chcbaram/stm32h5-w6300/hardware/stm32h5_w6300 v1.pdf

D

6 | 5 | 4 | 3 | 2 | 1

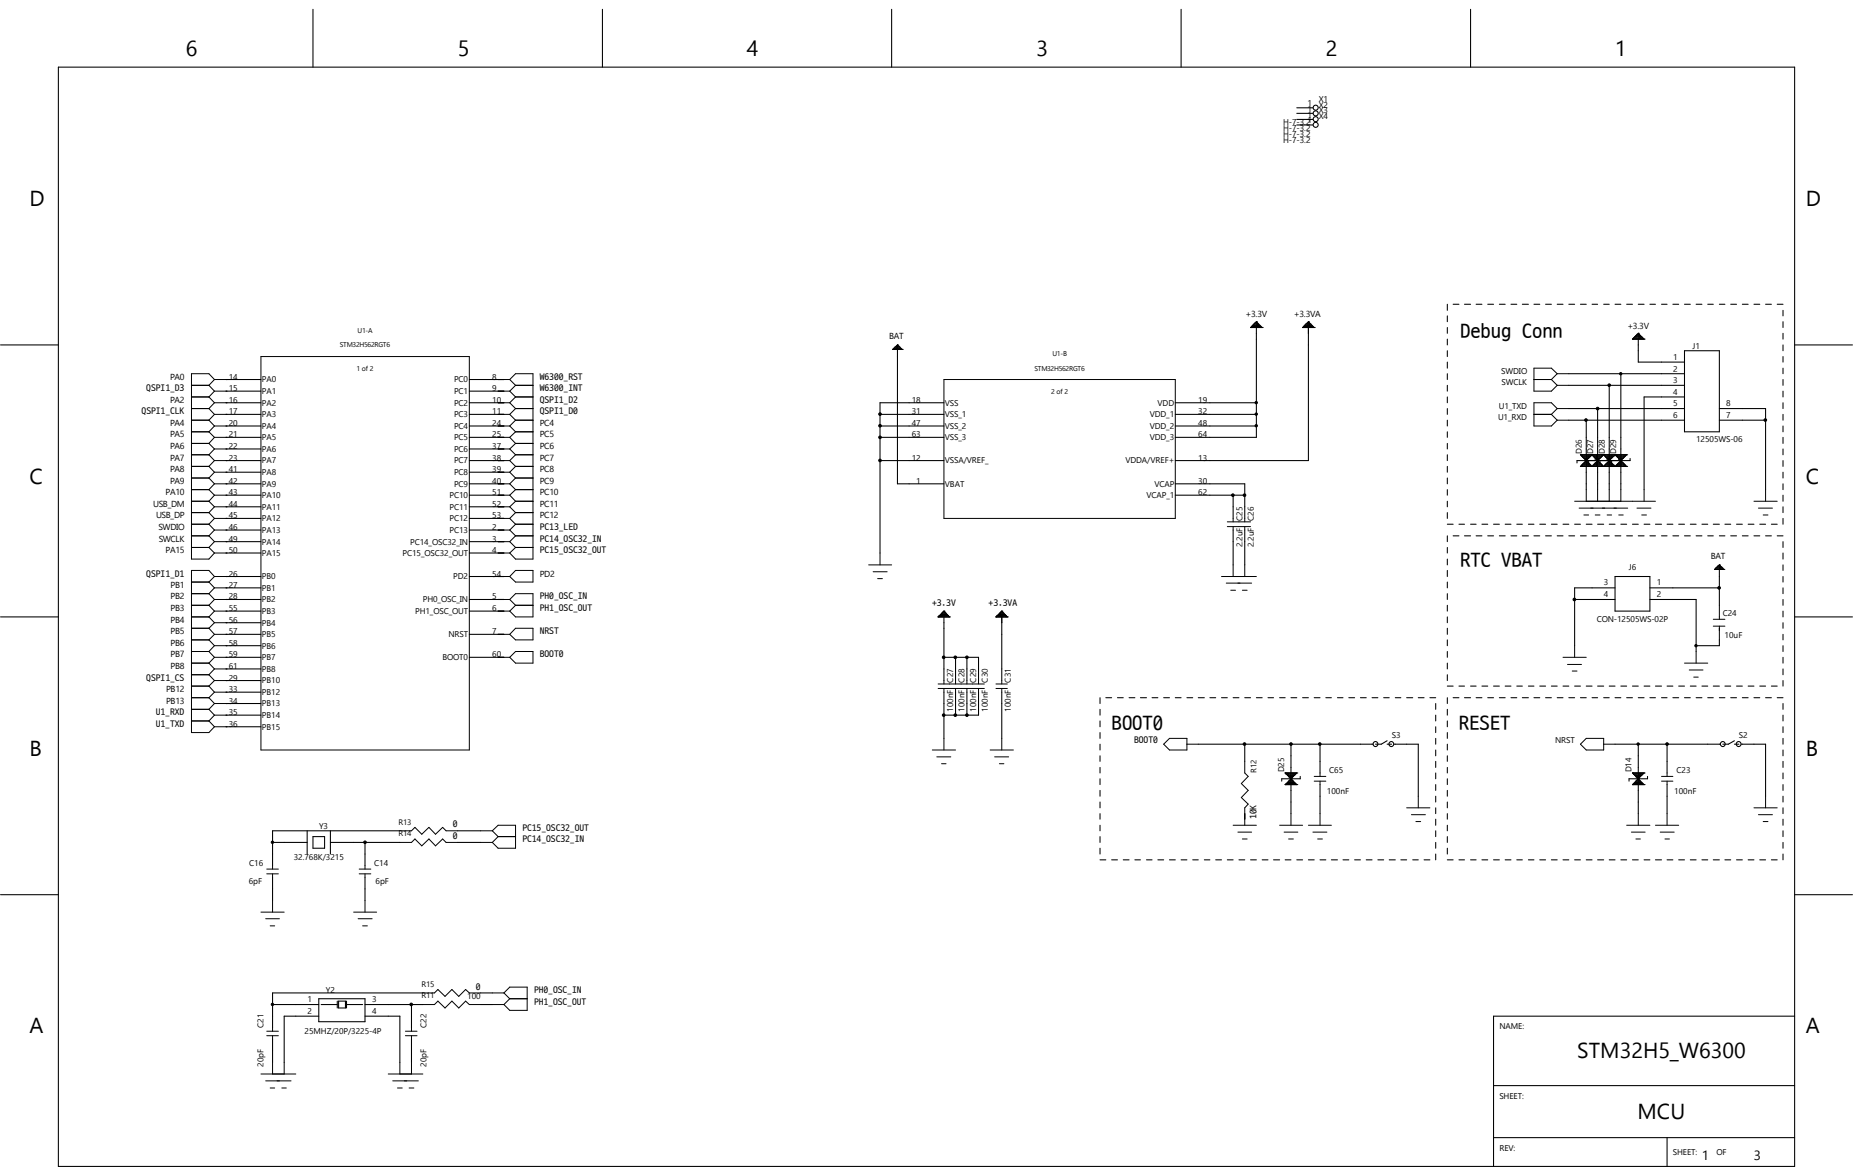
[picture p1: page 1]

12505WS-06 D²⁶ D²⁷ D²⁸ D²⁹

D

6 | 5 | 4 | 3 | 2 | 1

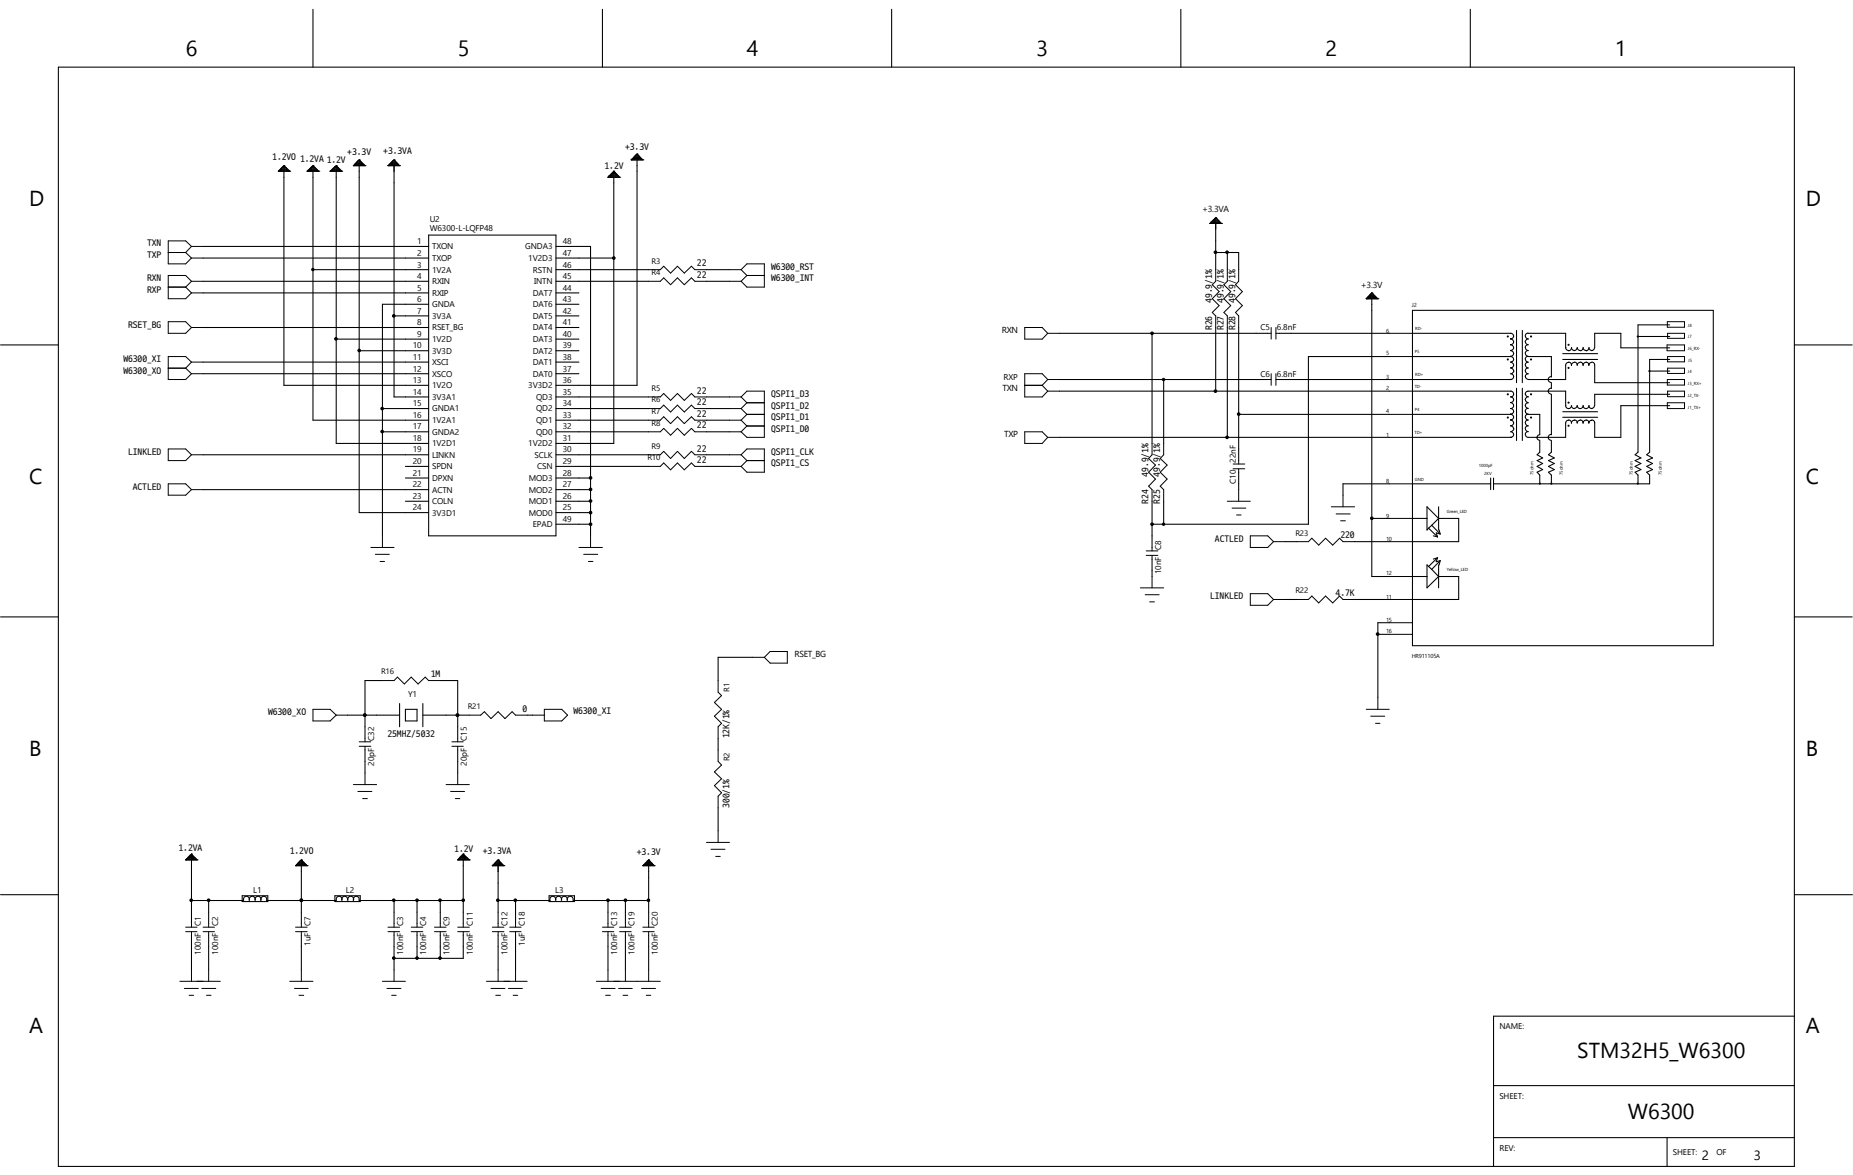
[picture p2: page 2]

2 | 47 1V2D3
3 | 46 RSTN 45 INTN 44 DAT7 43 DAT6 42 DAT5 41 DAT4 40 DAT3 39 DAT2 38 DAT1 37 DAT0 36 3V3D2

D

6 | 5 | 4 | 3 | 2 | 1

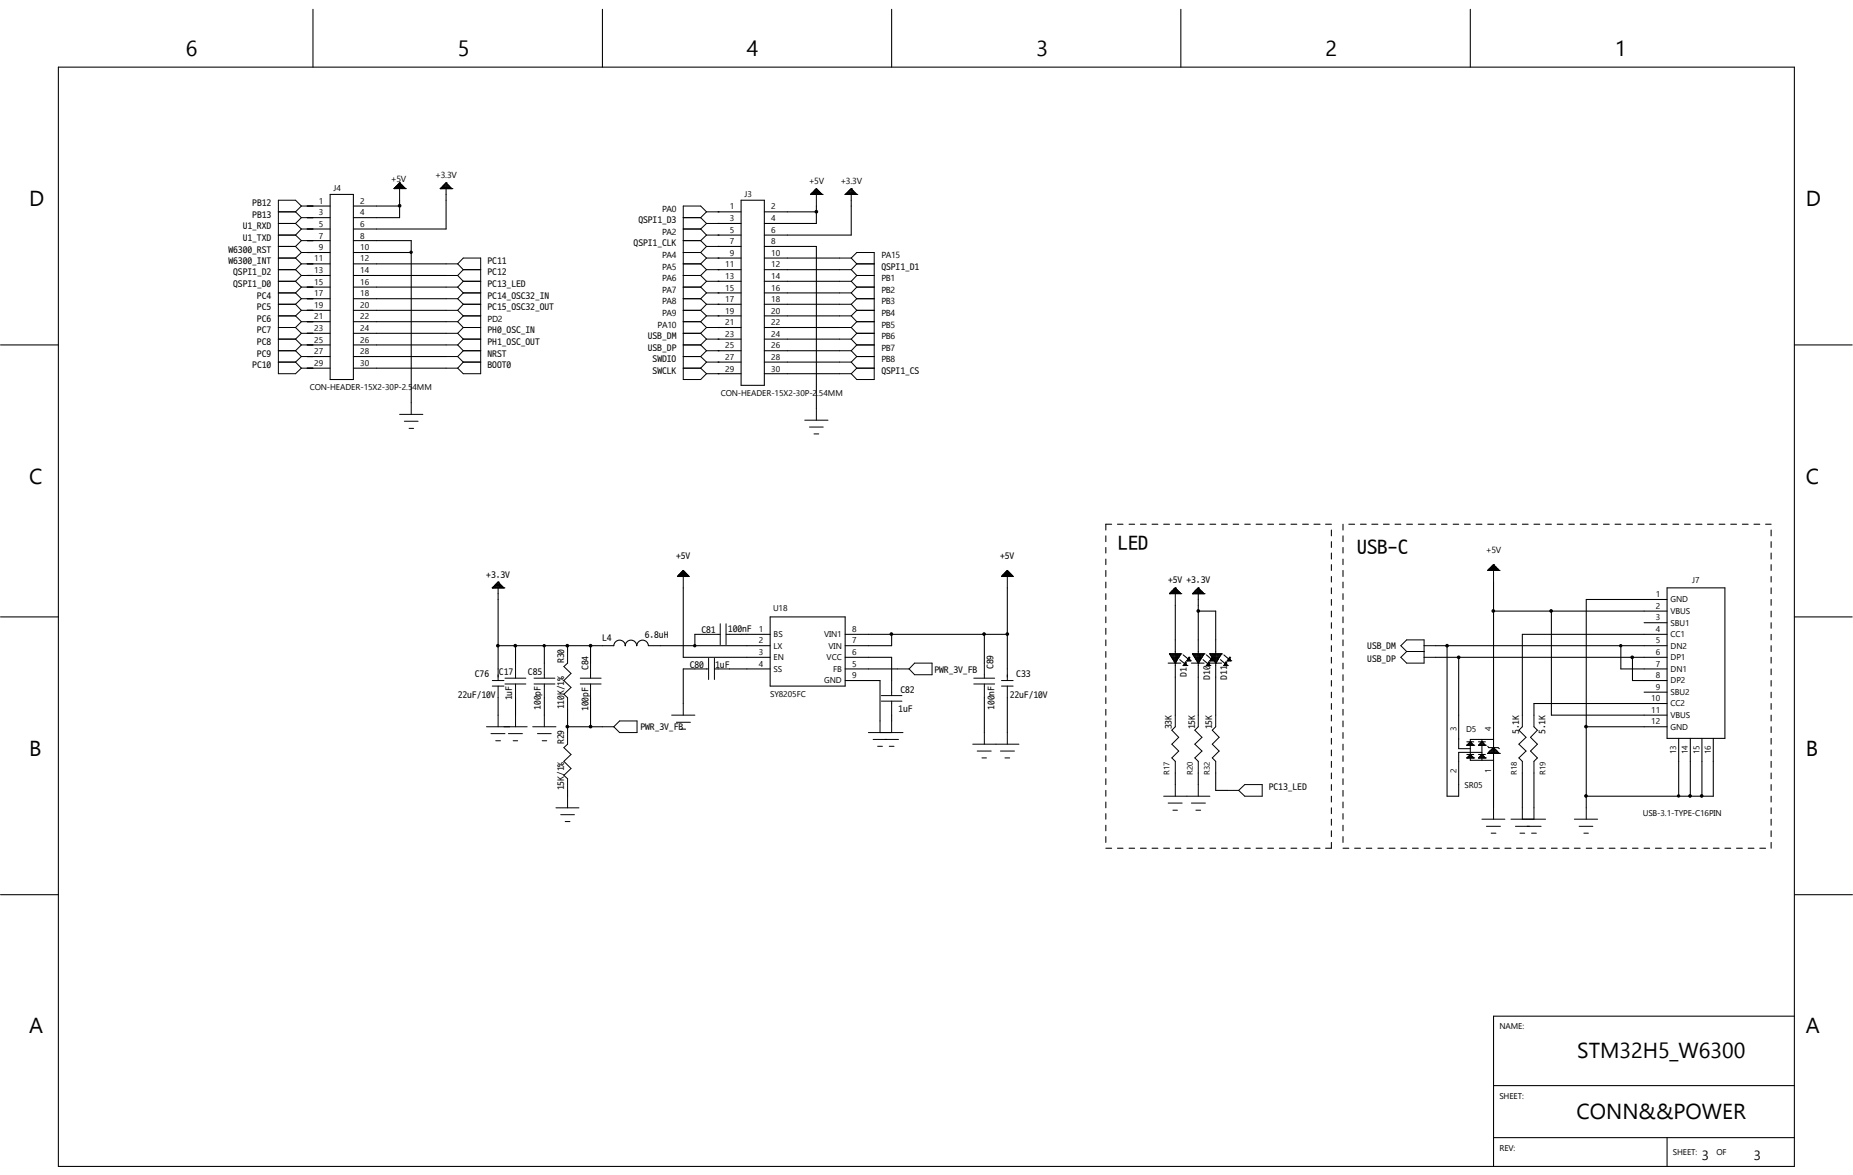
[picture p3: page 3]
