chcbaram/stm32h5-w6300/firmware/stm32h5-cube/stm32h5-w6300.ioc

Mcu.UserName=STM32H563RITx
PA1.Signal=OCTOSPI1_IO3
PA11.Signal=USB_DM
PA12.Signal=USB_DP
PA13(JTMS/SWDIO).Signal=DEBUG_JTMS-SWDIO
PA14(JTCK/SWCLK).Signal=DEBUG_JTCK-SWCLK
PA3.Signal=OCTOSPI1_CLK
PB0.Signal=OCTOSPI1_IO1
PB10.Signal=OCTOSPI1_NCS
PB14.Signal=USART1_TX
PB15.Signal=USART1_RX
PC13.GPIO_Label=LED
PC13.Signal=GPIO_Output
PC14-OSC32_IN(OSC32_IN).Signal=RCC_OSC32_IN
PC15-OSC32_OUT(OSC32_OUT).Signal=RCC_OSC32_OUT
PC2.Signal=OCTOSPI1_IO2
PC3.Signal=OCTOSPI1_IO0
PH0-OSC_IN(PH0).Signal=RCC_OSC_IN
PH1-OSC_OUT(PH1).Signal=RCC_OSC_OUT
