chcbaram/stm32h5-w6300/firmware/stm32h5-fw/src/hw/driver/uart.c

#include "uart.h"
#include "qbuffer.h"
#include "cli.h"
#if HW_USE_CDC == 1
#include "cdc.h"
#endif

#ifdef _USE_HW_UART


#define UART_RX_BUF_LENGTH        1024



typedef struct
{
  bool is_open;
  uint32_t baud;

  uint8_t  rx_buf[UART_RX_BUF_LENGTH];
  qbuffer_t qbuffer;
  UART_HandleTypeDef *p_huart;
  DMA_HandleTypeDef  *p_hdma_rx;

  uint32_t rx_cnt;
  uint32_t tx_cnt;
} uart_tbl_t;

typedef struct
{
  const char         *p_msg;
  USART_TypeDef      *p_uart;
  UART_HandleTypeDef *p_huart;
  bool                is_rs485;
  uart_driver_t      *p_driver;
} uart_hw_t;



#if CLI_USE(HW_UART)
static void cliUart(cli_args_t *args);
#endif


static bool is_init = false;

// .non_cache 섹션은 링커스크립트에 정의되어 있지 않아 orphan 으로 배치된다.
// 그 결과 startup 의 .data 복사(_sdata.._edata)와 .bss 클리어(_sbss.._ebss)
// 어느 쪽에도 포함되지 않아 부팅 시 쓰레기값이 남고, 플래시도 낭비된다.
// non-cacheable 배치 자체가 불필요하므로 속성을 뗀다.
static uart_tbl_t uart_tbl[UART_MAX_CH];

static UART_HandleTypeDef huart1;
static DMA_NodeTypeDef Node_GPDMA1_Channel0;
static DMA_QListTypeDef List_GPDMA1_Channel0;
static DMA_HandleTypeDef handle_GPDMA1_Channel0;

//   UART3/4 는 물리 포트가 아니라 uartSetDriver() 로 붙는 가상 채널이다.
//   NET  : cli_net.c   (텔넷)
//   CMD  : drv_cli.c   (cmd 패킷 위의 CLI. HID/CDC 어느 쪽이든 여기로 온다)
//   항목 수가 UART_MAX_CH 와 어긋나면 나머지가 0 으로 채워져 이름이 NULL 이 된다.
static uart_hw_t uart_hw_tbl[UART_MAX_CH] = 
  {
    {"USART1 SWD   ", USART1, &huart1, false, NULL},
    {"USB CDC      ", NULL,   NULL   , false, NULL},
    {"NET TELNET   ", NULL,   NULL   , false, NULL},
    {"CMD CLI      ", NULL,   NULL   , false, NULL},
  };





bool uartInit(void)
{
  for (int i=0; i<UART_MAX_CH; i++)
  {
    uart_tbl[i].is_open = false;
    uart_tbl[i].baud = 57600;
    uart_tbl[i].rx_cnt = 0;
    uart_tbl[i].tx_cnt = 0;    
  }

  is_init = true;

#if CLI_USE(HW_UART)
  cliAdd("uart", cliUart);
#endif
  return true;
}

bool uartSetDriver(uint8_t ch, uart_driver_t *p_driver)
{
  if (ch >= UART_MAX_CH)
    return false;

  uart_hw_tbl[ch].p_driver = p_driver;
  return true;
}

bool uartDeInit(void)
{
  return true;
}

bool uartIsInit(void)
{
  return is_init;
}

bool uartOpen(uint8_t ch, uint32_t baud)
{
  bool ret = false;
  HAL_StatusTypeDef ret_hal;


  if (ch >= UART_MAX_CH) return false;

  if (uart_tbl[ch].is_open == true && uart_tbl[ch].baud == baud)
  {
    return true;
  }

  if (uart_hw_tbl[ch].p_driver != NULL)
  {
    ret                  = uart_hw_tbl[ch].p_driver->open(baud);
    uart_tbl[ch].is_open = ret;
    uart_tbl[ch].baud    = baud;
    return ret;
  }  

  switch(ch)
  {
    case _DEF_UART1:
      uart_tbl[ch].baud      = baud;

      uart_tbl[ch].p_huart   = uart_hw_tbl[ch].p_huart;
      uart_tbl[ch].p_huart->Instance = uart_hw_tbl[ch].p_uart;    

      uart_tbl[ch].p_huart->Init.BaudRate       = baud;
      uart_tbl[ch].p_huart->Init.WordLength     = UART_WORDLENGTH_8B;
      uart_tbl[ch].p_huart->Init.StopBits       = UART_STOPBITS_1;
      uart_tbl[ch].p_huart->Init.Parity         = UART_PARITY_NONE;
      uart_tbl[ch].p_huart->Init.Mode           = UART_MODE_TX_RX;
      uart_tbl[ch].p_huart->Init.HwFlowCtl      = UART_HWCONTROL_NONE;
      uart_tbl[ch].p_huart->Init.OverSampling   = UART_OVERSAMPLING_16;
      uart_tbl[ch].p_huart->Init.OneBitSampling = UART_ONE_BIT_SAMPLE_DISABLE;
      uart_tbl[ch].p_huart->Init.ClockPrescaler = UART_PRESCALER_DIV1;
      uart_tbl[ch].p_huart->AdvancedInit.AdvFeatureInit = UART_ADVFEATURE_SWAP_INIT;
      uart_tbl[ch].p_huart->AdvancedInit.Swap           = UART_ADVFEATURE_SWAP_ENABLE;


      qbufferCreate(&uart_tbl[ch].qbuffer, &uart_tbl[ch].rx_buf[0], UART_RX_BUF_LENGTH);


      __HAL_RCC_GPDMA1_CLK_ENABLE();

      HAL_UART_DeInit(uart_tbl[ch].p_huart);

      if (uart_hw_tbl[ch].is_rs485 == true)
      {
        ret_hal = HAL_RS485Ex_Init(uart_tbl[ch].p_huart, UART_DE_POLARITY_HIGH, 0, 0);
      }
      else
      {
        ret_hal = HAL_UART_Init(uart_tbl[ch].p_huart);
      }

      if (ret_hal == HAL_OK)
      {
        ret = true;
        uart_tbl[ch].is_open = true;

        if(HAL_UART_Receive_DMA(uart_tbl[ch].p_huart, (uint8_t *)&uart_tbl[ch].rx_buf[0], UART_RX_BUF_LENGTH) != HAL_OK)
        {
          ret = false;
        }

        uart_tbl[ch].qbuffer.in  = uart_tbl[ch].qbuffer.len - uart_tbl[ch].p_huart->hdmarx->Instance->CBR1;
        uart_tbl[ch].qbuffer.out = uart_tbl[ch].qbuffer.in;
      }
      break;

    case _DEF_UART2:
      uart_tbl[ch].baud    = baud;
      uart_tbl[ch].is_open = true;
      ret = true;
      break;      
  }

  return ret;
}

bool uartClose(uint8_t ch)
{
  if (ch >= UART_MAX_CH) return false;

  uart_tbl[ch].is_open = false;

  if (uart_hw_tbl[ch].p_driver != NULL)
  {
    uart_hw_tbl[ch].p_driver->close();
  }

  return true;
}

uint32_t uartAvailable(uint8_t ch)
{
  uint32_t ret = 0;


  if (uart_hw_tbl[ch].p_driver != NULL)
  {
    ret = uart_hw_tbl[ch].p_driver->available();
    return ret;
  }

  switch(ch)
  {
    case _DEF_UART1:
      uart_tbl[ch].qbuffer.in = (uart_tbl[ch].qbuffer.len - uart_tbl[ch].p_huart->hdmarx->Instance->CBR1);
      ret = qbufferAvailable(&uart_tbl[ch].qbuffer);      
      break;

    case _DEF_UART2:
      #if HW_USE_CDC == 1
      ret = cdcAvailable();
      #endif
      break;      
  }

  return ret;
}

bool uartFlush(uint8_t ch)
{
  uint32_t pre_time;


  pre_time = millis();
  while(uartAvailable(ch))
  {
    if (millis()-pre_time >= 10)
    {
      break;
    }
    uartRead(ch);
  }

  return true;
}

uint8_t uartRead(uint8_t ch)
{
  uint8_t ret = 0;


  if (uart_hw_tbl[ch].p_driver != NULL)
  {
    ret = uart_hw_tbl[ch].p_driver->read();
    return ret;
  }

  switch(ch)
  {
    case _DEF_UART1:
      qbufferRead(&uart_tbl[ch].qbuffer, &ret, 1);
      break;

    case _DEF_UART2:
      #if HW_USE_CDC == 1
      ret = cdcRead();
      #endif
      break;      
  }
  uart_tbl[ch].rx_cnt++;

  return ret;
}

uint32_t uartWrite(uint8_t ch, uint8_t *p_data, uint32_t length)
{
  uint32_t ret = 0;


  if (uart_hw_tbl[ch].p_driver != NULL)
  {
    ret = uart_hw_tbl[ch].p_driver->write(p_data, length);
    return ret;
  }

  switch(ch)
  {
    case _DEF_UART1:
      if (HAL_UART_Transmit(uart_tbl[ch].p_huart, p_data, length, 100) == HAL_OK)
      {
        ret = length;
      }
      break;

    case _DEF_UART2:
      #if HW_USE_CDC == 1
      ret = cdcWrite(p_data, length);
      #endif
      break;      
  }
  uart_tbl[ch].tx_cnt += ret;

  return ret;
}

uint32_t uartPrintf(uint8_t ch, const char *fmt, ...)
{
  char buf[256];
  va_list args;
  int len;
  uint32_t ret;

  va_start(args, fmt);
  len = vsnprintf(buf, 256, fmt, args);

  ret = uartWrite(ch, (uint8_t *)buf, len);

  va_end(args);


  return ret;
}

uint32_t uartGetBaud(uint8_t ch)
{
  uint32_t ret = 0;


  if (ch >= UART_MAX_CH) return 0;

  #if HW_USE_CDC == 1
  if (ch == HW_UART_CH_USB)
    ret = cdcGetBaud();
  else
    ret = uart_tbl[ch].baud;
  #else
  ret = uart_tbl[ch].baud;
  #endif
  
  return ret;
}

uint32_t uartGetRxCnt(uint8_t ch)
{
  if (ch >= UART_MAX_CH) return 0;

  return uart_tbl[ch].rx_cnt;
}

uint32_t uartGetTxCnt(uint8_t ch)
{
  if (ch >= UART_MAX_CH) return 0;

  return uart_tbl[ch].tx_cnt;
}

void HAL_UART_MspInit(UART_HandleTypeDef* uartHandle)
{
  GPIO_InitTypeDef GPIO_InitStruct = {0};
  DMA_NodeConfTypeDef NodeConfig= {0};
  RCC_PeriphCLKInitTypeDef PeriphClkInitStruct = {0};

  if(uartHandle->Instance==USART1)
  {
  /** Initializes the peripherals clock
  */
    PeriphClkInitStruct.PeriphClockSelection = RCC_PERIPHCLK_USART1;
    PeriphClkInitStruct.Usart1ClockSelection = RCC_USART1CLKSOURCE_PCLK2;
    if (HAL_RCCEx_PeriphCLKConfig(&PeriphClkInitStruct) != HAL_OK)
    {
      Error_Handler();
    }

    /* USART1 clock enable */
    __HAL_RCC_USART1_CLK_ENABLE();

    __HAL_RCC_GPIOB_CLK_ENABLE();
    /**USART1 GPIO Configuration
    PB14     ------> USART1_TX
    PB15     ------> USART1_RX
    */
    GPIO_InitStruct.Pin = GPIO_PIN_14|GPIO_PIN_15;
    GPIO_InitStruct.Mode = GPIO_MODE_AF_PP;
    GPIO_InitStruct.Pull = GPIO_NOPULL;
    GPIO_InitStruct.Speed = GPIO_SPEED_FREQ_LOW;
    GPIO_InitStruct.Alternate = GPIO_AF4_USART1;
    HAL_GPIO_Init(GPIOB, &GPIO_InitStruct);


    /* USART1 DMA Init */
    /* GPDMA1_REQUEST_USART1_RX Init */
    NodeConfig.NodeType = DMA_GPDMA_LINEAR_NODE;
    NodeConfig.Init.Request = GPDMA1_REQUEST_USART1_RX;
    NodeConfig.Init.BlkHWRequest = DMA_BREQ_SINGLE_BURST;
    NodeConfig.Init.Direction = DMA_PERIPH_TO_MEMORY;
    NodeConfig.Init.SrcInc = DMA_SINC_FIXED;
    NodeConfig.Init.DestInc = DMA_DINC_INCREMENTED;
    NodeConfig.Init.SrcDataWidth = DMA_SRC_DATAWIDTH_BYTE;
    NodeConfig.Init.DestDataWidth = DMA_DEST_DATAWIDTH_BYTE;
    NodeConfig.Init.SrcBurstLength = 1;
    NodeConfig.Init.DestBurstLength = 1;
    NodeConfig.Init.TransferAllocatedPort = DMA_SRC_ALLOCATED_PORT0|DMA_DEST_ALLOCATED_PORT0;
    NodeConfig.Init.TransferEventMode = DMA_TCEM_BLOCK_TRANSFER;
    NodeConfig.Init.Mode = DMA_NORMAL;
    NodeConfig.TriggerConfig.TriggerPolarity = DMA_TRIG_POLARITY_MASKED;
    NodeConfig.DataHandlingConfig.DataExchange = DMA_EXCHANGE_NONE;
    NodeConfig.DataHandlingConfig.DataAlignment = DMA_DATA_RIGHTALIGN_ZEROPADDED;
    if (HAL_DMAEx_List_BuildNode(&NodeConfig, &Node_GPDMA1_Channel0) != HAL_OK)
    {
      Error_Handler();
    }

    if (HAL_DMAEx_List_InsertNode(&List_GPDMA1_Channel0, NULL, &Node_GPDMA1_Channel0) != HAL_OK)
    {
      Error_Handler();
    }

    if (HAL_DMAEx_List_SetCircularMode(&List_GPDMA1_Channel0) != HAL_OK)
    {
      Error_Handler();
    }

    handle_GPDMA1_Channel0.Instance = GPDMA1_Channel0;
    handle_GPDMA1_Channel0.InitLinkedList.Priority = DMA_LOW_PRIORITY_LOW_WEIGHT;
    handle_GPDMA1_Channel0.InitLinkedList.LinkStepMode = DMA_LSM_FULL_EXECUTION;
    handle_GPDMA1_Channel0.InitLinkedList.LinkAllocatedPort = DMA_LINK_ALLOCATED_PORT0;
    handle_GPDMA1_Channel0.InitLinkedList.TransferEventMode = DMA_TCEM_BLOCK_TRANSFER;
    handle_GPDMA1_Channel0.InitLinkedList.LinkedListMode = DMA_LINKEDLIST_CIRCULAR;
    if (HAL_DMAEx_List_Init(&handle_GPDMA1_Channel0) != HAL_OK)
    {
      Error_Handler();
    }

    if (HAL_DMAEx_List_LinkQ(&handle_GPDMA1_Channel0, &List_GPDMA1_Channel0) != HAL_OK)
    {
      Error_Handler();
    }

    __HAL_LINKDMA(uartHandle, hdmarx, handle_GPDMA1_Channel0);

    if (HAL_DMA_ConfigChannelAttributes(&handle_GPDMA1_Channel0, DMA_CHANNEL_NPRIV) != HAL_OK)
    {
      Error_Handler();
    }
  }
}

void HAL_UART_MspDeInit(UART_HandleTypeDef* uartHandle)
{
  if(uartHandle->Instance==USART1)
  {
    /* Peripheral clock disable */
    __HAL_RCC_USART1_CLK_DISABLE();

    /**USART1 GPIO Configuration
    PB14     ------> USART1_TX
    PB15     ------> USART1_RX
    */
    HAL_GPIO_DeInit(GPIOB, GPIO_PIN_14|GPIO_PIN_15);

    /* USART1 DMA DeInit */
    HAL_DMA_DeInit(uartHandle->hdmarx);
  }
}

#if CLI_USE(HW_UART)
void cliUart(cli_args_t *args)
{
  bool ret = false;


  if (args->argc == 1 && args->isStr(0, "info"))
  {
    for (int i=0; i<UART_MAX_CH; i++)
    {
      cliPrintf("_DEF_UART%d : %s, %d bps\n", i+1, uart_hw_tbl[i].p_msg, uartGetBaud(i));
    }
    ret = true;
  }

  if (args->argc == 2 && args->isStr(0, "test"))
  {
    uint8_t uart_ch;

    uart_ch = constrain(args->getData(1), 1, UART_MAX_CH) - 1;

    if (uart_ch != cliGetPort())
    {
      uint8_t rx_data;

      while(1)
      {
        if (uartAvailable(uart_ch) > 0)
        {
          rx_data = uartRead(uart_ch);
          cliPrintf("<- _DEF_UART%d RX : 0x%X\n", uart_ch + 1, rx_data);
        }

        if (cliAvailable() > 0)
        {
          rx_data = cliRead();
          if (rx_data == 'q')
          {
            break;
          }
          else
          {
            uartWrite(uart_ch, &rx_data, 1);
            cliPrintf("-> _DEF_UART%d TX : 0x%X\n", uart_ch + 1, rx_data);            
          }
        }
      }
    }
    else
    {
      cliPrintf("This is cliPort\n");
    }
    ret = true;
  }

  if (ret == false)
  {
    cliPrintf("uart info\n");
    cliPrintf("uart test ch[1~%d]\n", HW_UART_MAX_CH);
  }
}
#endif


#endif
