chcbaram/stm32h5-w6300/firmware/stm32h5-fw/src/hw/hw.h

#ifndef HW_H_
#define HW_H_

#ifdef __cplusplus
extern "C" {
#endif

#include "hw_def.h"


#include "led.h"
#include "uart.h"
#include "cli.h"
#include "log.h"
#include "fault.h"
#include "swtimer.h"
#include "reset.h"
#include "rtc.h"
#include "qbuffer.h"
#include "util_core.h"
#include "usb.h"
#include "cdc.h"
#include "hid.h"
#include "gpio.h"
#include "flash.h"
#include "wiz_spi.h"
#ifdef _USE_HW_WIZNET
#include "wiznet/wiznet.h"
#endif
#include "event.h"
#include "osal/thread.h"


bool hwInit(void);


#ifdef __cplusplus
}
#endif

#endif
