chcbaram/stm32h5-w6300/firmware/stm32h5-fw/src/hw/driver/rtc.c

#include "rtc.h"
#include "util_core.h"



#ifdef _USE_HW_RTC
#include "cli.h"
#include <time.h>


#ifdef _USE_HW_CLI
static void cliRtc(cli_args_t *args);
#endif

static RTC_HandleTypeDef hrtc;
static bool is_init = false;





bool rtcInit(void)
{
  bool ret = true;
  RTC_PrivilegeStateTypeDef privilegeState = {0};

  hrtc.Instance = RTC;
  hrtc.Init.HourFormat = RTC_HOURFORMAT_24;
  hrtc.Init.AsynchPrediv = 127;
  hrtc.Init.SynchPrediv = 255;
  hrtc.Init.OutPut = RTC_OUTPUT_DISABLE;
  hrtc.Init.OutPutRemap = RTC_OUTPUT_REMAP_NONE;  
  hrtc.Init.OutPutPolarity = RTC_OUTPUT_POLARITY_HIGH;
  hrtc.Init.OutPutType = RTC_OUTPUT_TYPE_OPENDRAIN;
  hrtc.Init.OutPutRemap = RTC_OUTPUT_REMAP_NONE;
  if (HAL_RTC_Init(&hrtc) != HAL_OK)
  {
    ret = false;
  }

  privilegeState.rtcPrivilegeFull = RTC_PRIVILEGE_FULL_NO;
  privilegeState.backupRegisterPrivZone = RTC_PRIVILEGE_BKUP_ZONE_NONE;
  privilegeState.backupRegisterStartZone2 = RTC_BKP_DR0;
  privilegeState.backupRegisterStartZone3 = RTC_BKP_DR0;
  if (HAL_RTCEx_PrivilegeModeSet(&hrtc, &privilegeState) != HAL_OK)
  {
    Error_Handler();
  }

  logPrintf("[%s] rtcInit()\n", ret ? "OK":"E_");
  is_init = ret;

#ifdef _USE_HW_CLI
  cliAdd("rtc", cliRtc);
#endif
  return ret;
}

bool rtcGetInfo(rtc_info_t *rtc_info)
{
  RTC_TimeTypeDef sTime = {0};
  RTC_DateTypeDef sDate = {0};


  if (HAL_RTC_GetTime(&hrtc, &sTime, RTC_FORMAT_BIN) != HAL_OK)
    return false;

  if (HAL_RTC_GetDate(&hrtc, &sDate, RTC_FORMAT_BIN) != HAL_OK)
    return false;

  rtc_info->time.hours = sTime.Hours;
  rtc_info->time.minutes = sTime.Minutes;
  rtc_info->time.seconds = sTime.Seconds;

  rtc_info->date.year = sDate.Year;
  rtc_info->date.month = sDate.Month;
  rtc_info->date.day = sDate.Date;

  return true;
}

bool rtcGetTime(rtc_time_t *rtc_time)
{
  RTC_TimeTypeDef sTime = {0};
  RTC_DateTypeDef sDate = {0};


  if (HAL_RTC_GetTime(&hrtc, &sTime, RTC_FORMAT_BIN) != HAL_OK)
    return false;

  if (HAL_RTC_GetDate(&hrtc, &sDate, RTC_FORMAT_BIN) != HAL_OK)
    return false;

  rtc_time->hours = sTime.Hours;
  rtc_time->minutes = sTime.Minutes;
  rtc_time->seconds = sTime.Seconds;

  return true;
}

bool rtcGetDate(rtc_date_t *rtc_date)
{
  RTC_TimeTypeDef sTime = {0};
  RTC_DateTypeDef sDate = {0};


  if (HAL_RTC_GetTime(&hrtc, &sTime, RTC_FORMAT_BIN) != HAL_OK)
    return false;

  if (HAL_RTC_GetDate(&hrtc, &sDate, RTC_FORMAT_BIN) != HAL_OK)
    return false;

  rtc_date->year = sDate.Year;
  rtc_date->month = sDate.Month;
  rtc_date->day = sDate.Date;


  struct tm  timeinfo;

  memset(&timeinfo, 0, sizeof(timeinfo));
  timeinfo.tm_year  = (2000 + sDate.Year) - 1900;
  timeinfo.tm_mon   = sDate.Month - 1;
  timeinfo.tm_mday  = sDate.Date;
  timeinfo.tm_hour  = sTime.Hours;
  timeinfo.tm_min   = sTime.Minutes;
  timeinfo.tm_sec   = sTime.Seconds;

  mktime(&timeinfo);

  rtc_date->week = timeinfo.tm_wday;

  return true;
}

bool rtcSetTime(rtc_time_t *rtc_time)
{
  RTC_TimeTypeDef sTime = {0};
  RTC_DateTypeDef sDate = {0};


  if (HAL_RTC_GetTime(&hrtc, &sTime, RTC_FORMAT_BIN) != HAL_OK)
    return false;

  if (HAL_RTC_GetDate(&hrtc, &sDate, RTC_FORMAT_BIN) != HAL_OK)
    return false;

  sTime.Hours = rtc_time->hours;
  sTime.Minutes = rtc_time->minutes;
  sTime.Seconds = rtc_time->seconds;

  if (HAL_RTC_SetTime(&hrtc, &sTime, RTC_FORMAT_BIN) != HAL_OK)
    return false;

  return true;
}

bool rtcSetDate(rtc_date_t *rtc_date)
{
  RTC_TimeTypeDef sTime = {0};
  RTC_DateTypeDef sDate = {0};


  if (HAL_RTC_GetTime(&hrtc, &sTime, RTC_FORMAT_BIN) != HAL_OK)
    return false;

  if (HAL_RTC_GetDate(&hrtc, &sDate, RTC_FORMAT_BIN) != HAL_OK)
    return false;

  sDate.Year = rtc_date->year;
  sDate.Month = rtc_date->month;
  sDate.Date = rtc_date->day;

  if (HAL_RTC_SetDate(&hrtc, &sDate, RTC_FORMAT_BIN) != HAL_OK)
    return false;

  return true;
}

void HAL_RTC_MspInit(RTC_HandleTypeDef* rtcHandle)
{
  RCC_PeriphCLKInitTypeDef PeriphClkInitStruct = {0};
 
  if(rtcHandle->Instance==RTC)
  {
    /** Initializes the peripherals clock
    */
    PeriphClkInitStruct.PeriphClockSelection = RCC_PERIPHCLK_RTC;
    PeriphClkInitStruct.RTCClockSelection = RCC_RTCCLKSOURCE_LSE;
    if (HAL_RCCEx_PeriphCLKConfig(&PeriphClkInitStruct) != HAL_OK)
    {
      Error_Handler();
    }

    /* RTC clock enable */
    __HAL_RCC_RTC_ENABLE();
    __HAL_RCC_RTCAPB_CLK_ENABLE();
  }
}

//-- epoch <-> 달력.
//
//   계산 자체는 util_core.c 에 있다. 여기서는 RTC 읽기/쓰기와 "시각을 아는가"
//   판정만 한다. 계산을 분리해 두면 호스트 유닛 테스트가 같은 구현을 시험한다.
//
uint32_t rtcGetEpoch(void)
{
  rtc_info_t info;
  uint16_t   year;

  if (rtcGetInfo(&info) != true)
    return 0;

  year = 2000 + info.date.year;

  // 맞춘 적이 없으면 리셋 기본값(2000년대 초)에 머문다. 믿지 않는다.
  if (year < RTC_EPOCH_YEAR_MIN)
    return 0;

  return utilEpochFromCivil(year, info.date.month, info.date.day,
                            info.time.hours, info.time.minutes, info.time.seconds);
}

bool rtcEpochToInfo(uint32_t epoch, rtc_info_t *p_info)
{
  uint16_t year;
  uint8_t  month, day, hour, min, sec;

  if (utilCivilFromEpoch(epoch, &year, &month, &day, &hour, &min, &sec) != true)
    return false;

  if (year < 2000 || year > 2255)
    return false;

  p_info->date.year    = (uint8_t)(year - 2000);
  p_info->date.month   = month;
  p_info->date.day     = day;
  p_info->date.week    = 0;
  p_info->time.hours   = hour;
  p_info->time.minutes = min;
  p_info->time.seconds = sec;
  return true;
}

bool rtcSetEpoch(uint32_t epoch)
{
  rtc_info_t info;

  if (rtcEpochToInfo(epoch, &info) != true)
    return false;

  if (rtcSetDate(&info.date) != true)
    return false;

  return rtcSetTime(&info.time);
}

bool rtcSetReg(uint32_t index, uint32_t data)
{
  if (IS_RTC_BKP(index))
  {
    HAL_RTCEx_BKUPWrite(&hrtc, index, data);
    return true;
  }
  else
  {
    return false;
  }
}

bool rtcGetReg(uint32_t index, uint32_t *p_data)
{
  if (IS_RTC_BKP(index))
  {
    *p_data = HAL_RTCEx_BKUPRead(&hrtc, index);
    return true;
  }
  else
  {
    return false;
  }
}

void HAL_RTC_MspDeInit(RTC_HandleTypeDef* rtcHandle)
{

  if(rtcHandle->Instance==RTC)
  {
    __HAL_RCC_RTC_DISABLE();
  }
}

#ifdef _USE_HW_CLI
void cliRtc(cli_args_t *args)
{
  bool ret = false;


  if (args->argc == 1 && args->isStr(0, "info"))
  {
    cliPrintf("is_init : %d\n", is_init);
    ret = true;
  }

  if (args->argc == 2 && args->isStr(0, "get") && args->isStr(1, "info"))
  {
    rtc_info_t rtc_info;

    while(cliKeepLoop())
    {
      rtcGetInfo(&rtc_info);

      cliPrintf("Y:%02d M:%02d D:%02d, H:%02d M:%02d S:%02d\n",
                rtc_info.date.year,
                rtc_info.date.month,
                rtc_info.date.day,
                rtc_info.time.hours,
                rtc_info.time.minutes,
                rtc_info.time.seconds);
      delay(1000);
    }
    ret = true;
  }

  if (args->argc == 5 && args->isStr(0, "set") && args->isStr(1, "time"))
  {
    rtc_time_t rtc_time;

    rtc_time.hours = args->getData(2);
    rtc_time.minutes = args->getData(3);
    rtc_time.seconds = args->getData(4);

    rtcSetTime(&rtc_time);
    cliPrintf("H:%02d M:%02d S:%02d\n",
              rtc_time.hours,
              rtc_time.minutes,
              rtc_time.seconds);
    ret = true;
  }

  if (args->argc == 5 && args->isStr(0, "set") && args->isStr(1, "date"))
  {
    rtc_date_t rtc_date;

    rtc_date.year = args->getData(2);
    rtc_date.month = args->getData(3);
    rtc_date.day = args->getData(4);

    rtcSetDate(&rtc_date);
    cliPrintf("Y:%02d M:%02d D:%02d\n",
              rtc_date.year,
              rtc_date.month,
              rtc_date.day);
    ret = true;
  }


  if (ret == false)
  {
    cliPrintf("rtc info\n");
    cliPrintf("rtc get info\n");
    cliPrintf("rtc set time [h] [m] [s]\n");
    cliPrintf("rtc set date [y] [m] [d]\n");
  }
}
#endif

#endif
