chcbaram/stm32h5-w6300/firmware/stm32h5-fw/src/hw/hw.c

#include "hw.h"



extern uint32_t _fw_flash_begin;

volatile const firm_ver_t firm_ver __attribute__((section(".version"))) = 
{
  .magic_number = VERSION_MAGIC_NUMBER,
  .version_str  = _DEF_FIRMWATRE_VERSION,
  .name_str     = _DEF_BOARD_NAME,
  .firm_addr    = (uint32_t)&_fw_flash_begin
};



bool hwInit(void)
{  
  cliInit();
  logInit();  
  swtimerInit();
  ledInit();
  uartInit();
  for (int i=0; i<HW_UART_MAX_CH; i++)
  {
    uartOpen(i, 115200);
  }

  logOpen(HW_LOG_CH, 115200);
  logPrintf("\r\n[ Firmware Begin... ]\r\n");
  logPrintf("Booting..Name \t\t: %s\r\n", _DEF_BOARD_NAME);
  logPrintf("Booting..Ver  \t\t: %s\r\n", _DEF_FIRMWATRE_VERSION);  
  logPrintf("Booting..Clock\t\t: %d Mhz\r\n", (int)HAL_RCC_GetSysClockFreq()/1000000);
  logPrintf("Booting..Date \t\t: %s\r\n", __DATE__); 
  logPrintf("Booting..Time \t\t: %s\r\n", __TIME__); 
  logPrintf("Booting..Addr \t\t: 0x%X\r\n", (uint32_t)&_fw_flash_begin); 

  logPrintf("\n");

  rtcInit();
  resetInit();    
  faultInit();
  assertInit();
  gpioInit();
  flashInit();
  
  usbInit();
#if HW_USE_CMP == 1
  usbBegin(USB_CMP_MODE);
#else
  usbBegin(USB_CDC_MODE);
#endif
  cdcInit();
#if HW_USE_HID == 1
  hidInit();
#endif
    
  eventInit();  
  wiznetInit();
  wiznetDHCP();
  wiznetSNTP();

  logBoot(false);
  
  return true;
}
