chcbaram/stm32h5-w6300/firmware/stm32h5-boot/src/hw/driver/usb/tusb_config.h

#ifndef _TUSB_CONFIG_H_
#define _TUSB_CONFIG_H_

#ifdef __cplusplus
 extern "C" {
#endif

//--------------------------------------------------------------------+
// Board Specific Configuration
//--------------------------------------------------------------------+

#ifndef BOARD_TUD_RHPORT
#define BOARD_TUD_RHPORT      0
#endif

#ifndef BOARD_TUD_MAX_SPEED
#define BOARD_TUD_MAX_SPEED   OPT_MODE_FULL_SPEED
#endif

//--------------------------------------------------------------------
// COMMON CONFIGURATION
//--------------------------------------------------------------------

#define CFG_TUSB_MCU          OPT_MCU_STM32H5

#ifndef CFG_TUSB_OS
#define CFG_TUSB_OS           OPT_OS_NONE
#endif

#ifndef CFG_TUSB_DEBUG
#define CFG_TUSB_DEBUG        0
#endif

#define CFG_TUD_ENABLED       1
#define CFG_TUD_MAX_SPEED     BOARD_TUD_MAX_SPEED

#ifndef CFG_TUSB_MEM_SECTION
#define CFG_TUSB_MEM_SECTION
#endif

#ifndef CFG_TUSB_MEM_ALIGN
#define CFG_TUSB_MEM_ALIGN          __attribute__ ((aligned(4)))
#endif

//--------------------------------------------------------------------
// DEVICE CONFIGURATION
//--------------------------------------------------------------------

#ifndef CFG_TUD_ENDPOINT0_SIZE
#define CFG_TUD_ENDPOINT0_SIZE    64
#endif

//------------- CLASS -------------//
//  MSC : UF2 드래그&드롭
//  CDC : CLI + cmd 패킷
//  HID : WebHID 업데이트 (vendor-defined usage page)
//
#define CFG_TUD_CDC               1
#define CFG_TUD_MSC               1
#define CFG_TUD_HID               1
#define CFG_TUD_MIDI              0
#define CFG_TUD_VENDOR            0

#define CFG_TUD_CDC_RX_BUFSIZE    256
#define CFG_TUD_CDC_TX_BUFSIZE    256
#define CFG_TUD_CDC_EP_BUFSIZE    64

#define CFG_TUD_MSC_EP_BUFSIZE    512

#define CFG_TUD_HID_EP_BUFSIZE    64

#ifdef __cplusplus
 }
#endif

#endif /* _TUSB_CONFIG_H_ */
