chcbaram/stm32h5-w6300/firmware/stm32h5-boot/src/ap/modules/cmd/driver/cmd_hid.c

#include "cmd_task.h"

#if defined(_USE_HW_CMD) && defined(_USE_HW_USB) && CFG_TUD_HID

#include "usb.h"
#include "qbuffer.h"


//-- HID 채널 드라이버.
//
//   HID 는 스트림이 아니라 64바이트 고정 리포트 단위다. cmd.c 는 바이트 스트림을
//   기대하므로, 수신 리포트를 링버퍼에 풀어 넣고 송신은 64바이트로 잘라 보낸다.
//
//   리포트 [0]  = 유효 바이트 수 (1~63)
//   리포트 [1:] = 페이로드
//
//   길이를 앞에 두는 이유: HID 는 항상 64바이트를 꽉 채워 보내므로 패딩과 실제
//   데이터를 구분할 방법이 필요하다. 패딩을 그냥 흘려보내면 cmd.c 의 패킷 파서가
//   쓰레기 바이트를 먹는다.
//
#define HID_RPT_SIZE      CFG_TUD_HID_EP_BUFSIZE      // 64
#define HID_PAYLOAD_MAX   (HID_RPT_SIZE - 1)          // 63
#define HID_RX_BUF_SIZE   2048

static uint8_t  rx_buf[HID_RX_BUF_SIZE];
static qbuffer_t rx_q;
static bool     is_init = false;


static void cmdHidInitOnce(void)
{
  if (is_init)
    return;
  qbufferCreate(&rx_q, rx_buf, HID_RX_BUF_SIZE);
  is_init = true;
}

//-- TinyUSB 가 호스트로부터 리포트를 받으면 부른다.
//   USB 콜백 안이므로 링버퍼에 넣기만 하고 처리는 메인 루프에서 한다.
//
void cmdHidRxReport(uint8_t const *buffer, uint16_t bufsize)
{
  uint8_t n;

  cmdHidInitOnce();

  if (bufsize < 1)
    return;

  n = buffer[0];
  if (n > HID_PAYLOAD_MAX)
    n = HID_PAYLOAD_MAX;
  if (n > bufsize - 1)
    n = (uint8_t)(bufsize - 1);

  qbufferWrite(&rx_q, (uint8_t *)&buffer[1], n);
}


static bool cmdHidOpen(void *args)
{
  (void)args;
  cmdHidInitOnce();
  return true;
}

static bool cmdHidClose(void *args)
{
  (void)args;
  return true;
}

static uint32_t cmdHidAvailable(void *args)
{
  (void)args;
  cmdHidInitOnce();
  return qbufferAvailable(&rx_q);
}

static bool cmdHidFlush(void *args)
{
  (void)args;
  cmdHidInitOnce();
  qbufferFlush(&rx_q);
  return true;
}

static uint8_t cmdHidRead(void *args)
{
  uint8_t data = 0;

  (void)args;
  cmdHidInitOnce();
  qbufferRead(&rx_q, &data, 1);
  return data;
}

static uint32_t cmdHidWrite(void *args, uint8_t *p_data, uint32_t length)
{
  uint32_t sent = 0;

  (void)args;

  if (usbIsInit() != true)
    return 0;

  while (sent < length)
  {
    uint8_t  rpt[HID_RPT_SIZE];
    uint32_t n = length - sent;
    uint32_t pre_time;

    if (n > HID_PAYLOAD_MAX)
      n = HID_PAYLOAD_MAX;

    memset(rpt, 0, sizeof(rpt));
    rpt[0] = (uint8_t)n;
    memcpy(&rpt[1], &p_data[sent], n);

    // IN 엔드포인트가 빌 때까지 기다린다. tud_task() 를 계속 돌려야 비워진다.
    pre_time = millis();
    while (tud_hid_ready() != true)
    {
      usbUpdate();
      if (millis() - pre_time >= 100)
        return sent;
    }

    if (tud_hid_report(0, rpt, sizeof(rpt)) != true)
      return sent;

    sent += n;
  }
  return sent;
}


cmd_driver_t cmd_hid_driver =
{
  .open      = cmdHidOpen,
  .close     = cmdHidClose,
  .available = cmdHidAvailable,
  .flush     = cmdHidFlush,
  .read      = cmdHidRead,
  .write     = cmdHidWrite,
};

#endif
