chcbaram/stm32h5-w6300/(commit log)

2025-10-24 초기 프로젝트 추가
2025-10-24 ioc 업데이트
2025-10-25 빌드 폴더 제거
2025-10-25 build 폴더 제외
2025-10-25 빌드시 경고 제거
2025-10-26 W6300 추가
2025-10-26 QSPI 타이밍 수정
2025-11-14 신규 보드 업데이트
2025-11-14 tcp test 중
2025-11-30 loopback 테스트 중
2026-04-01 qspi read/write시 딜레이 추가
2026-06-06 module 추가
2026-06-06 CLI NET 추가
2026-06-06 코드 정리
2026-08-22 ignore 추가
2026-08-22 stm32h5-boot 부트로더 추가 (UF2 / CDC / HID)
    STM32H563 용 128KB 부트로더. 리셋 버튼 더블클릭으로 진입하면 USB 대용량저장장치로
    열거되고 .uf2 를 드래그&드롭하면 펌웨어가 갱신된다. 같은 장치가 CDC(CLI)와
    HID(WebHID)로도 동시에 열거된다.
    플래시 배치
    Bank1 BOOT 128K(0x08000000) + FIRM 448K(0x08020000) + 예약 448K
    Bank2 SLOT0 448K + SLOT1 448K + BOOT_LOG 16K + NVS 112K
    슬롯은 역할 고정 없이 핑퐁으로 쓴다. FIRM 과 (fw_size, fw_crc) 가 일치하는
    슬롯이 현재 이미지의 백업본이고, 불일치하는 쪽이 새 이미지 수신 대상이다.
    덕분에 업데이트당 복사가 1회로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
2026-08-22 폴트 자동 복구 / 부트 이벤트 로그 / 앱 연동
    부트로더
    - bootUp() 판정을 완성했다.
    (0) 지난 부팅의 ECC 2비트 오류 영역 정리
    (1) MODE_BIT_BOOT (2) 리셋 더블클릭
    (3) 폴트 반복 -> 자동 복구 (4) 부팅 미확인 반복 -> 롤백
    (5) MODE_BIT_UPDATE 적용 (6) 점프
    (3)(4)는 같은 경로를 쓰고 로그 이벤트만 다르다. 롤백한 이미지마저 죽으면
    롤백 슬롯이 없어(-1) UF2 모드로 빠지므로 무한 롤백 루프가 생기지 않는다.
    - 부트 이벤트 로그(0x081E0000, 8KB 섹터 2개 핑퐁)를 추가했다.
    정상 부팅은 기록하지 않고 UPDATE/ROLLBACK/FAU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
2026-08-22 호스트 유닛 테스트 추가 (전원 손실 전수 시뮬레이션)
    boot.c / boot_log.c 는 flash.h 인터페이스에만 의존하도록 짰으므로, 목 플래시로
    바꿔 끼워 네이티브 gcc 로 그대로 돌릴 수 있다. 하드웨어가 필요 없다.
    cd firmware/stm32h5-boot/test/host && ./run.sh
    목 플래시의 존재 이유는 동작을 흉내내는 것이 아니라 STM32H5 제약을 강제하는 것이다.
    - 소거 단위 8KB, 프로그램 단위 16B
    - 16B 정렬이 아닌 기록 거부
    - 이미 프로그램된 쿼드워드 재기록 거부
    (실기에서는 HAL 이 OK 를 반환하고 ECC 만 조용히 깨진다)
    - FLASH_PROTECT_* 영역 기록 거부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
2026-08-22 VSCode 태스크 / 디버그 구성 추가 (pyocd + ST-LINK)
    태스크를 그룹 접두어로 묶었다.
    Build - build / clean / rebuild
    Flash - pyocd / STM32_Programmer_CLI (앱은 UF2 경로가 기본)
    Device - reset / erase all / monitor boot log
    Test - host unit
    Setup - pyocd install pack
    App -, Boot - 상대 프로젝트 빌드/플래시
    pyocd 를 주 경로로 삼았다. STM32H5 는 pyocd 내장 타겟이 아니라서 CMSIS-Pack 을
    한 번 설치해야 한다(Setup - pyocd install pack). 품번은 STM32H563RITx 다.
    플래시/디버그 모두 실기에서 확인했다.
    OpenOCD 는 쓰지 않기로 했다. 확인 결과 이 조합으로는 동작하지 않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
2026-08-22 cmd 패킷 프로토콜 추가 (CDC 채널)
    apm32e103-kit 의 cmd.c 를 그대로 가져왔다. 전송계층과 무관하게 설계되어 있어서
    open/close/available/flush/read/write 여섯 개만 채우면 같은 커맨드 셋이 그대로
    동작한다. 이번엔 CDC 채널만 붙였고, HID(11단계)와 향후 이더넷(UDP)도 같은 방식이다.
    커맨드 셋은 슬롯 구조에 맞게 다시 설계했다.
    INFO 플래시 배치와 familyID
    VERSION FIRM/SLOT0/SLOT1 의 seq·크기·CRC·이름·버전 + write/pending/rollback
    FW_BEGIN bootGetWriteSlot() 으로 쓸 슬롯을 정하고 크기를 받는다
    FW_ERASE / FW_WRITE / FW_READ
    FW_END CRC 를 플래시에서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
2026-08-22 HID 채널 + WebHID 웹 업데이터 추가
    cmd_hid.c 를 추가해 cmd 커맨드 셋을 HID 로도 받는다. cmd.c 가 전송계층과
    무관하게 설계되어 있어 드라이버 6개 함수만 채우면 되고, CDC 와 완전히 같은
    커맨드가 동작한다.
    HID 는 스트림이 아니라 64바이트 고정 리포트다. 펌웨어/호스트/웹이 같은 규약을 쓴다.
    리포트[0] = 유효 바이트 수 (1~63)
    리포트[1:] = 페이로드
    길이를 앞에 두지 않으면 패딩과 실제 데이터를 구분할 수 없어 패킷 파서가
    쓰레기 바이트를 먹는다.
    호스트 도구
    download.py 를 앱 프로젝트(tools/download/)로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
2026-08-22 웹/툴이 부트로더와 앱을 구분하도록 INFO 확장
    부트로더와 앱이 같은 VID/PID 로 열거되므로 USB 만으로는 어느 쪽에 붙었는지 알 수 없다.
    연결 직후 가장 먼저 부르는 BOOT_CMD_INFO 응답에 실행 모드와 자기 이름/버전을 실었다.
    boot_info_t 에 mode(HW_DEV_MODE_BOOT/APP) 와 name[32]/version[32] 추가.
    mode 는 각 프로젝트 hw_def.h 의 HW_DEV_MODE 매크로에서 온다.
    웹 페이지는 이 값으로 화면을 나눈다.
    - 헤더에 BOOTLOADER / APP 배지를 띄운다.
    - 각 패널이 modes 를 선언하고, 연결된 쪽에서 의미 있는 패널만 탭에 남는다.
    펌웨어 갱신 패널은 부트로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
2026-08-22 타깃 통합 테스트(pytest) + HID CLI + 웹 CLI 패널
    타깃 통합 테스트
    test/target 에 pytest 하네스를 넣었다. ST-LINK VCP CLI, HID cmd 채널, SWD 를
    픽스처로 감싸고 부트 모드 진입까지 자동으로 한다.
    test_01_flash 보호/정렬/재기록 가드, 뱅크1·2 소거·기록
    test_02_reset 소프트 리셋 미집계, 폴트 카운터(md 로 하드폴트 유발)
    test_03_boot 슬롯 판정 일관성, 부트 로그
    test_04_cmd CDC 와 HID 가 같은 값을 돌려주는지
    test_05_update UF2 드롭 갱신, HID 다운로드
    실행: cd test/target && python3 -m pytest
    11 passed (flash/boot, 2분 9초)
    HID CLI
    cmd 패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
2026-08-22 문서 정리 + 작업 현황/로드맵 기록
    남아 있던 문서를 마저 썼다.
    08-slot-pingpong 슬롯 선택 규칙, seq 가 필요한 이유(다운그레이드 버그)
    09-fault-recovery 판정 순서, 두 카운터, 부트 로그 핑퐁
    09b-power-loss 커밋 순서 규칙과 전수 시뮬레이션으로 증명한 내용
    12-app-changes 앱 필수 변경과 공용 파일 목록
    13-test 두 계층 테스트 실행법
    새로 추가한 것.
    STATUS.md 현재 어디까지 됐고 다음에 뭘 하는지. 개발 환경 실측값과
    실기에서 잡은 함정 9가지를 한곳에 모았다.
    14-roadmap.md 확정했지만 아직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
2026-08-22 앱에 HID(ST composite) + cmd 채널 추가
    웹페이지가 부트로더에서만 쓸 수 있던 도구에서, 앱 상태에서도 보드를 다룰 수
    있는 도구가 된다. 앱 CLI 를 웹에서 그대로 돌리고, 실행 중인 채로 펌웨어를
    슬롯에 받아두고, 웹에서 부트로더로 재진입할 수 있다.
    USB 스택은 갈지 않았다. 앱의 STM32_USB_Device_Library 가 이미 composite 를
    지원하고 있었고(USE_USBD_COMPOSITE 가드가 core/ctlreq/cdc 에 다 있다), 빠져
    있던 것은 빌더 파일 하나뿐이었다. 스택을 갈면 인터럽트·클럭·PMA·CDC 를 전부
    다시 검증해야 한다.
    ITF0/1 CDC (IAD) EP 0x81/0x01/0x82
    ITF2 HI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
2026-08-22 보드 시각(RTC epoch) 문서 + 부트 이벤트 표 시각 오프셋 수정
    부트 이벤트 표가 시각을 9시간 앞서 보여줬다. epoch 을 "달력 필드를 UTC 로
    간주해" 만드는데 getHours() 같은 지역시 접근자로 찍어서다(KST 기준 +9h).
    표시는 전부 epochToText() 를 거치게 했고, 다른 곳에 같은 실수가 남아 있지
    않은지 훑어 확인했다.
    문서 두 개를 새로 쓰고 STATUS 를 갱신했다.
    15-app-hid.md 앱 HID/composite + cmd 채널. 밟은 함정 아홉 가지
    16-rtc-time.md 보드 시각. 지역시 처리 약속과 "시각을 모르는 경우"
2026-08-22 같은 펌웨어를 다시 올렸을 때 "적용됐다" 고 잘못 말하던 것 수정
    슬롯에 받아둔 이미지가 지금 FIRM 과 같으면 bootGetPendingSlot() 이 -1 이라
    부트로더는 적용할 것이 없어 아무 일도 하지 않는다. 재부팅만 하고 끝난다.
    그런데 호스트에는 "적용 요청 완료. 부트로더가 FIRM 에 복사한 뒤 재부팅한다"
    고 나갔다. 실패도 아닌데 아무 일도 일어나지 않았고 부트 이벤트 로그에도 남지
    않으니, 사용자는 "기록이 왜 안 남지" 로 받아들인다.
    조용히 아무 일도 하지 않는 것은 조용히 실패하는 것만큼 나쁘다.
    앱의 FW_UPDATE 가 ERR_BOOT_NO_PENDI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
    [cmd_boot.c, download.py]
2026-08-22 폴트 PC 를 폴트 직후 부팅에서만 남기고, 네트워크 상태 조회 추가
    faultGetPc() 가 .noinit 에 남은 값을 영원히 돌려주고 있었다. is_reg 는 한 번
    서면 지워지지 않아서, 오래전 폴트의 PC 가 폴트와 무관한 롤백/검증 실패 기록에도
    계속 찍혔다. 전원을 막 넣은 뒤라면 아예 SRAM 쓰레기값(0x20000000)이 나왔다.
    faultInit() 이 매직을 보고 한 번만 걷어 담는다. 매직은 그 자리에서 지우므로
    다음 부팅에는 0 이 된다. 호출부(ap.c)는 손대지 않아도 자동으로 맞는다.
    BOOT_CMD_NET(0x0013) 으로 링크/DHCP/IP/서브넷/게이트웨이/DNS/MAC 을 돌려준다.
    이더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
2026-08-22 LAN 스캔과 이더넷 OTA, GitHub Pages 준비
    브라우저는 원시 네트워크 스캔을 할 수 없다. 그래서 USB 로 붙은 보드가 대신
    훑고 목록만 돌려준다. UDP 브로드캐스트 비컨(포트 5300)이고, 질의와 응답이
    같은 60바이트 구조체를 쓴다.
    NU87-TinyDK 의 discover.py / netDiscoverPoll() 을 참고했다. 다만 거기는 PC 가
    스캔하고 보드는 답하기만 하는데, 여기는 스캔하는 쪽이 MCU 라 방향이 반대다.
    그래서 텍스트 한 줄 대신 구조체를 쓴다 - 파싱하는 쪽이 MCU 이고, 받은 것을
    그대로 BOOT_CMD_NET_SCAN 응답에 실을 수 있어 재포장도 없다. NU87 에서 가져온
    것은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
2026-08-22 보드 웹페이지 링크를 서버가 생길 때까지 감춘다
    스캔 목록의 "열기" 와 네트워크 표의 "보드 웹페이지 열기" 는 http://보드IP 로
    가는데, 보드에 웹서버가 없어서 눌러도 연결 거부만 난다. 지킬 수 없는 링크를
    UI 에 그려놓은 셈이었다.
    BOARD_HTTP 플래그로 묶고 지금은 "웹서버 없음" 으로 알린다. 14-roadmap.md C 를
    구현하면 true 로 바꾸는 것만으로 링크가 살아난다.
    새 탭으로 여는 방식 자체는 맞다. HTTPS 인 GitHub Pages 에서 http://보드IP 로
    fetch/WebSocket 은 mixed content 로 막히지만 최상위 이동은 허용된다.
2026-08-22 보드 자체 웹서버 (HTTP + POST /cmd)
    보드가 자기 웹페이지를 서빙한다. 같은 출처라 mixed content 제약이 사라지고,
    USB 없이 네트워크만으로 업데이트·CLI·스캔이 다 된다.
    로드맵에는 WebSocket 이라고 적어뒀는데 POST 로 바꿨다. cmd 는 원래 요청/응답이라
    POST 한 번에 맞아떨어지고, WebSocket 은 업그레이드 핸드셰이크(SHA1+base64)와
    프레임 마스킹 해제로 MCU 에 200줄쯤이 더 붙는데 얻는 것은 서버 푸시뿐이다.
    푸시가 필요해지면 그때 더한다.
    페이지는 뱅크1 예약 영역이 아니라 앱 바이너리에 넣었다. gzip 후 18KB 라 부담이
    없고, 별도 굽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
2026-08-22 보드 페이지에서 스캔이 멈추던 것 수정, 화면 표시 정리
    웹에서 스캔을 누르면 "스캔 중..." 에서 멈췄다. netHttpUpdate() 에 재진입
    가드가 없어서다. LAN 스캔은 800ms 동안 delay() 로 도는데 그 delay() 가
    cliLoopIdle() -> moduleUpdate() 를 부르므로 HTTP 처리 도중에 다시 들어온다.
    처리 중인 연결에 다음 요청이 겹쳐 응답이 뒤섞였다.
    cmdTaskUpdate() 에는 같은 이유로 이미 가드가 있었다. 커맨드 처리가 길어질 수
    있는 곳은 다 필요하다.
    [hidden] 이 .row 의 display:flex 에 특이도로 밀려서, 보드가 서빙한 페이지에서
    "IP 를 알면 바로" 줄이 숨겨지지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
2026-08-22 MAC 을 칩 고유번호에서 만든다
    소스에 MAC 이 박혀 있었다({00,00,12,34,56,78}). 보드가 하나일 때는 아무 일도
    없지만 두 장이 되면 같은 MAC 이 두 개 생긴다. mDNS 이름 충돌을 어떻게 풀지
    이야기하다가 드러났는데, 이름보다 이게 먼저다 - 스위치의 MAC 테이블이 두 포트
    사이에서 뒤집히고, ARP 가 어느 쪽을 가리킬지 모르고, DHCP 서버가 같은
    클라이언트로 보고 같은 IP 를 두 장에 줄 수 있다.
    STM32 UID(96비트, 칩마다 다름)에서 만든다. 앞에 0x02 를 두어 locally
    administered 임을 표시한다. 실측 02:00:46:00:D2:FC.
    UID 주소를 utilCalcCRC() 에 그대로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
2026-08-22 mDNS 는 하지 않기로 하고 판단 근거를 남긴다
    소켓이 하나도 남지 않는다(0~7 을 telnet/DHCP/SNTP/cmd TCP/discovery/HTTP×3 이
    쓴다). 비우려면 cmd TCP 를 HTTP POST 로 대체하거나 HTTP 소켓을 줄여야 하는데,
    mDNS 가 주는 것은 "IP 대신 이름을 친다" 하나다.
    보드를 찾는 문제는 이미 스캔이 더 잘 푼다 - 비컨에 이름·버전·모드가 실려 오고
    discover.py --open 으로 바로 열리며 웹에 IP 입력칸도 있다. 브라우저에서 목록을
    얻는 것은 mDNS 로도 불가능하다(JS 에 mDNS API 가 없다).
    나중에 필요해지면 cmd TCP 를 비우는 쪽이 가장 깨끗하다는 것까지 적어뒀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
2026-08-22 슬롯 핑퐁 · 롤백 · 폴트 복구를 그림으로 설명한다
    글로만 설명하던 세 가지를 SVG 로 만들었다. 상태가 어떻게 옮겨가는지는 표보다
    그림이 낫다.
    slot-pingpong.svg v1 -> v2 -> 롤백 -> v3 네 단계의 FIRM/SLOT0/SLOT1 내용과
    그때 write/pending/rollback 이 무엇을 돌려주는지
    rollback-flow.svg 부팅 판정부터 점프까지. 되돌아갈 곳이 없으면 UF2 모드
    fault-recovery.svg 폴트 -> 카운터 -> 3회면 롤백. 확정하면 0 이 되는 자리까지
    gen_memory_map.py 와 같은 규칙을 따랐다. 글자는 블록 안에 두고, 색은
    prefers-color-scheme 에 기대지 않는다(r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
2026-08-22 이더넷 OTA 블록도 추가
    18 문서의 이더넷 OTA 절에 그림을 넣었다. 두 가지를 한 장에 담았다.
    위쪽은 왜 전송을 하나 더 붙이는 것이 쌌는지다. 호스트 네 종류가 각자 채널
    드라이버를 거쳐 같은 cmd.c / cmd_boot.c 로 모이고 같은 슬롯에 쓴다. 이더넷
    OTA 가 drv_tcp.c 하나로 끝나고 부트로더를 손대지 않은 이유가 이 그림이다.
    아래쪽은 왜 적용이 두 단계인지다. 앱은 자기가 실행 중인 뱅크1 을 지울 수 없어서
    슬롯에 받아두기만 하고, 실제 교체는 다음 부팅에 부트로더가 한다. 부트로더
    모드에서는 한 번에 끝나는 것도 같이 적었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
