chcbaram/stm32h5-w6300/(notices)

Notices in the files:
firmware/stm32h5-fw/src/hw/driver/wiznet/soc/W6300/w6300.h:
Copyright (c) 2019, WIZnet Co., LTD.
